jsarrett/EphemeralDonut/donutDriver/donutDriver.kicad_pcb

## KiCad design donutDriver/donutDriver.kicad_pcb (2024-11-14)

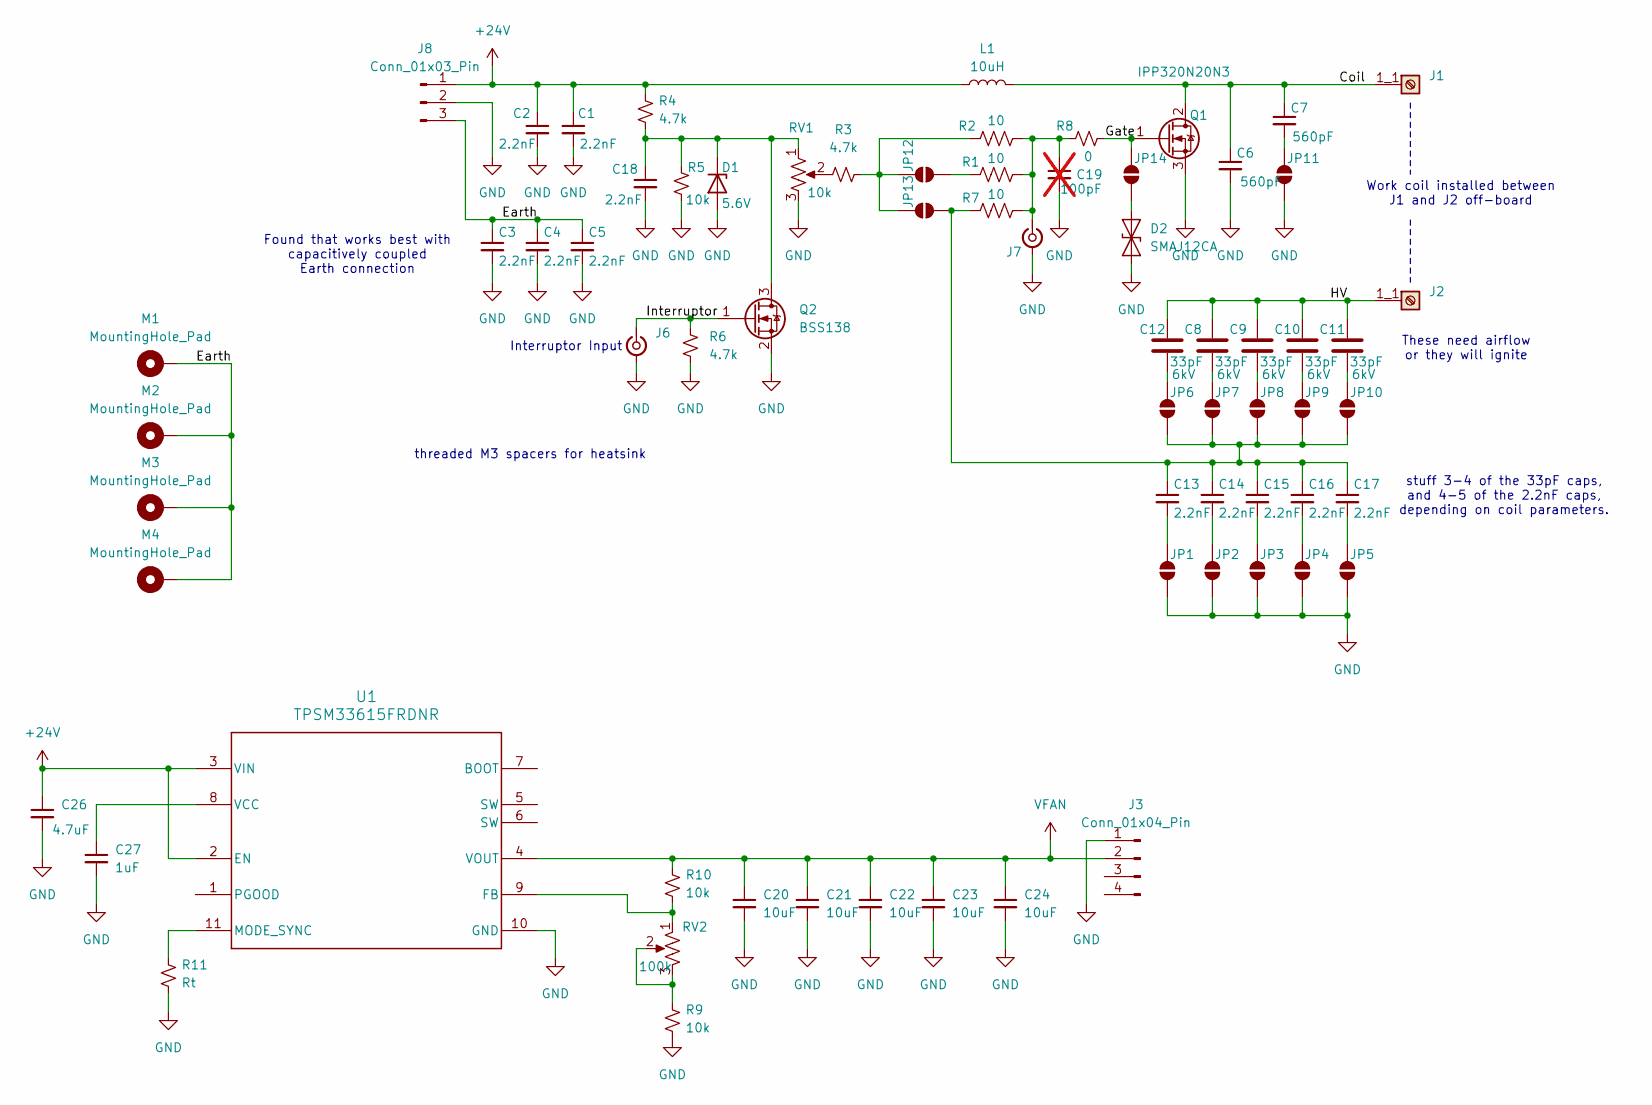
[picture p1: schematic donutDriver.kicad_sch]

Parts:
C1, C2, C3, C4, C5, C13, C14, C15, C16, C17, C18: 2.2nF; C_0805_2012Metric; Voltage 250V; MPN C0805C222JAGACAUTO
C6, C7: 560pF; C_1206_3216Metric; MPN CC1206JRNPOBBN561
C8, C9, C10, C11, C12: 33pF; TDK_Disc_D7.5mm_W5.0mm_P7.50mm; Voltage 6kV; MPN CC45SL3JD330JYNNA
C19: 100pF; C_1206_3216Metric; not fitted
C20, C21, C22, C23, C24: 10uF; C_0805_2012Metric
C26: 4.7uF; C_1210_3225Metric
C27: 1uF; C_0603_1608Metric
D1: 5.6V; D_SOD-323_HandSoldering; MPN CUHZ5V6.H3F
D2: SMAJ12CA; D_SMA
J1, J2: Keystone 7767; KEYSTONE_7767
J3: Conn_01x04_Pin; JST_XH_B4B-XH-A_1x04_P2.50mm_Vertical
J6, J7: Conn_Coaxial_Small; SMA_Amphenol_132134-11_Vertical
J8: Conn_01x03_Pin; CONN3_2601-3103_WAG
JP1, JP2, JP3, JP4, JP5, JP6, JP7, JP8, JP9, JP10, JP11, JP12, JP13, JP14: SolderJumper_2_Open; SolderJumper-2_P1.3mm_Open_RoundedPad1.0x1.5mm
L1: 10uH; L_Toroid_Vertical_L16.3mm_W7.1mm_P7.11mm_Pulse_H
M1, M2, M3, M4: MountingHole_Pad; WA-SMSI_9774025360
Q1: IPP320N20N3; TO-220-3_Horizontal_BoardCutout
Q2: BSS138; SOT-23
R1, R2, R7: 10; R_2512_6332Metric; MPN SR2512JK-7W10RL
R3, R4, R6: 4.7k; R_0603_1608Metric
R5, R9, R10: 10k; R_0603_1608Metric
R8: 0; R_1206_3216Metric
R11: Rt; R_0603_1608Metric
RV1: 10k; Potentiometer_Bourns_PTV09A-2_Single_Horizontal; MPN PTV09A-2025F-B103
RV2: 100k; Potentiometer_Bourns_PTV09A-2_Single_Horizontal; MPN PTV09A-2025F-B104
U1: TPSM33615FRDNR; RDN0011A-MFG

Connections:
+24V: C1.1, C2.1, C26.1, J8.1, L1.1, R4.2, U1.2 (EN), U1.3 (VIN)
/Coil: C6.1, C7.1, J1.1_1 (Pin_1), J1.1_2 (Pin_1), J1.1_3 (Pin_1), J1.1_4 (Pin_1), L1.2, Q1.2 (D)
/Earth: C3.1, C4.1, C5.1, J8.3, M1.1, M2.1, M3.1, M4.1
/Gate: JP14.2 (B), Q1.1 (G), R8.2
/HV: C8.1, C9.1, C10.1, C11.1, C12.1, J2.1_1 (Pin_1), J2.1_2 (Pin_1), J2.1_3 (Pin_1), J2.1_4 (Pin_1)
/Interruptor: J6.1 (In), Q2.1 (G), R6.2
GND: C1.2, C2.2, C3.2, C4.2, C5.2, C6.2, C18.2, C19.2, C20.2, C21.2, C22.2, C23.2, C24.2, C26.2, C27.2, D1.2 (A), D2.1 (A1), J3.1, J6.2 (Ext), J7.2 (Ext), J8.2, JP1.1 (A), JP2.1 (A), JP3.1 (A), JP4.1 (A), JP5.1 (A), JP11.1 (A), Q1.3 (S), Q2.2 (S), R5.1, R6.1, R9.1, R11.1, RV1.3, U1.10 (GND)
unnamed: C18.1, D1.1 (K), Q2.3 (D), R4.1, R5.2, RV1.1
unnamed: D2.2 (A2), JP14.1 (A)
unnamed: C19.1, J7.1 (In), R1.2, R2.2, R7.2, R8.1
unnamed: C13.2, JP1.2 (B)
unnamed: C14.2, JP2.2 (B)
unnamed: C15.2, JP3.2 (B)
unnamed: C16.2, JP4.2 (B)
unnamed: C17.2, JP5.2 (B)
unnamed: C12.2, JP6.2 (B)
unnamed: C8.2, JP7.2 (B)
unnamed: C9.2, JP8.2 (B)
unnamed: C10.2, JP9.2 (B)
unnamed: C13.1, C14.1, C15.1, C16.1, C17.1, JP6.1 (A), JP7.1 (A), JP8.1 (A), JP9.1 (A), JP10.1 (A), JP13.1 (A), R7.1
unnamed: C11.2, JP10.2 (B)
unnamed: C7.2, JP11.2 (B)
unnamed: JP12.1 (A), R1.1
unnamed: JP12.2 (B), JP13.2 (B), R2.1, R3.2
unnamed: R3.1, RV1.2
unnamed: R9.2, RV2.2, RV2.3
unnamed: R10.1, RV2.1, U1.9 (FB)
unnamed: R11.2, U1.11 (MODE_SYNC)
unnamed: C27.1, U1.8 (VCC)
VFAN: C20.1, C21.1, C22.1, C23.1, C24.1, J3.2, R10.2, U1.4 (VOUT)

Notes on the sheet:
Work coil installed between J1 and J2 off-board
Interruptor Input
threaded M3 spacers for heatsink
These need airflow or they will ignite
stuff 3-4 of the 33pF caps, and 4-5 of the 2.2nF caps, depending on coil parameters.
Found that works best with capacitively coupled Earth connection

Board: 2 copper layers, 69 parts (0 on the bottom side), 30 nets, no tracks yet.
