jsarrett/EphemeralDonut/(commit log)

2024-11-11 begin basic class E implementation
    schematic matches my handmade prototypes pretty closely
    [donutDriver.kicad_pcb, donutDriver.kicad_sch]
2024-11-12 begin pcb
    [donutDriver.kicad_pcb, donutDriver.kicad_sch]
2024-11-14 add fan switching regulator and jumpers
    [donutDriver.kicad_pcb, donutDriver.kicad_sch]
